nikolajevs/MISC/qb288-spool/README.md

# Печатная катушка для лифта лампы QB288

Катушка для троса на D-вал 6 мм мотор-редуктора **JGY-370, 12 В, 18 об/мин** (Aslong JGY-370B, например Evita.lt U-0096).
Рассчитана на лампу около 2 кг. Все размеры в миллиметрах.

## Файлы

| Файл | Что это |
|---|---|
| `spool_compact.stl` | **Основная версия.** Короткая, без ступицы, сидит на D-лыске и на клею. 15 г PETG. Не разбирается. |
| `spool_screw.stl` | Версия со ступицей, закладной гайкой M3 и стопорным винтом. Съёмная, но на 5 мм длиннее. 17 г PETG. |
| `d_fit_test.stl` | Пластинка с четырьмя D-отверстиями с разным зазором. Печатайте первой. |
| `spool.scad` | Параметрический исходник (OpenSCAD). Меняйте `flat_f`, `shaft_len`, `d_len`, `clear`, `core_d` и т.д. По умолчанию это compact, для screw задайте `hub_len = 4` и `flange_t = 3.5`. |

STL лежат в **печатной ориентации**: наружная щёчка на столе, D-отверстие или ступица смотрят вверх.

## 1. Сначала проверьте посадку

1. Измерьте штангенциркулем свой вал: диаметр, расстояние от лыски до противоположной стороны (по чертежам 5,4, допуск 5,3–5,5), длину вала от бобышки (чертёж Aslong 14 мм, даташит серии 16,5 мм, то есть 18,5 от корпуса, у продавцов 14–16) и длину лыски от конца вала (8–12).
2. Напечатайте `d_fit_test.stl`. Слева направо отверстия имеют зазор на сторону 0,05 / 0,10 / 0,15 / 0,20 мм по диаметру и на 0,05 мм больше по лыске (1–4 насечки на кромке).
3. Выберите отверстие, которое садится на вал от руки без люфта. Если это не 0,10 (по умолчанию), поменяйте `clear` в `spool.scad` и перегенерируйте STL.
4. Если лыска вала 5,45 мм и больше, поставьте измеренное значение в `flat_f`: при 5,5 зазор по лыске в модели всего около 0,05 мм.
5. Если лыска короче 8 мм, поправьте `d_len`: D-часть отверстия должна лежать только там, где у вала есть лыска.
6. **Зазор `gap` между торцом катушки и самой выступающей деталью на грани мотора.** Такая деталь это бобышка, поверхность L-кронштейна или головки винтов. Измерьте вылет вала `P` от этой детали и поставьте `gap` = `P` − 13,5 мм, но не меньше 0,5 мм. Тогда конец вала всегда оказывается на 13,5 мм от торца катушки и на 2 мм не доходит до дна, и те же STL подходят без перегенерации. Пример: по даташиту серии вал выступает на 18,5 мм от плоскости площадок, стальной L-кронштейн (3 мм) её поднимает на 3 мм, `P` = 15,5, `gap` = 2,0 мм. Если `P` < 14, `gap` получится меньше 0,5 мм: задайте в `spool.scad` `shaft_len` = `P` и `gap` = 0,5 и перегенерируйте катушку (D-часть сместится сама). Параметры `shaft_len` и `gap` в `spool.scad` меняйте только вместе. Как крепить сам мотор, см. лист 8 дизайна.

## 2. Печать

- Материал: **PETG** (PLA не брать: ползёт под нагрузкой при тепле палатки; нейлон тянет влагу).
- Слой 0,2 мм, сопло 0,4 мм, **5 периметров, заполнение 100%**.
- Ориентация как в STL. **Внутренняя щёчка Ø34 нависает над сердечником Ø26 на 4 мм**, это консоль, а не мост. Включите поддержки только от стола и только под этой щёчкой, зазор по Z 0,2 мм. Канавку поддержки не задевают. Если печатать без них, нижняя поверхность щёчки провиснет на десятые доли миллиметра и отпечатается неровной.
- Канавка винтовая, шаг 1,8 мм, полукруглый профиль радиусом 0,85 и глубиной 1,0 мм. Перемычки между витками очень узкие (около 0,1 мм), тоньше слоя, поэтому поверхность получится чешуйчатой. Трос лежит в круглом дне канавки, а не на перемычке, так что для работы это не страшно. Если боитесь, сначала распечатайте 15-мм кусок намотки.
- Версия `screw`: горизонтальное отверстие под винт и паз гайки печатаются мостом, это нормально. Гнездо Ø6,1 открыто на стол: после печати пройдите его свёрлом Ø6 (усадка и «слоновья нога» сужают устье).

## 3. Сборка

Общее:
1. Примерьте всухую: между торцом катушки и ближайшей деталью на грани мотора (бобышка, кронштейн, головки винтов) оставьте щуп толщиной `gap` (см. шаг 1.6). **Упора нет**: катушка не должна касаться этих деталей.

**Compact (клей, не разбирается):**
2. Зачистите вал и обезжирьте. Нанесите **эпоксидку или фиксатор для цилиндрических соединений** на дальнюю половину вала и на дно отверстия. У входа клея не оставляйте, чтобы он не выдавился в зазор 0,5 мм и не приклеил катушку к бобышке.
3. Наденьте катушку, держите щуп 0,5 мм до схватывания, до начала гелеобразования пару раз проверните катушку вручную.
4. Момент несут лыска и клей вместе: в compact основную долю берёт клеевой слой (расчётное касательное напряжение около 0,3–0,7 МПа при 0,25–0,5 Н·м). Разобрать можно только разрушив катушку.

**Screw (съёмная):**
2. Вставьте гайку M3 в паз со стороны торца ступицы (можно капля цианоакрилата).
3. Наденьте катушку, выставьте щуп 0,5 мм, затяните стопорный винт M3×6 (без головки) через отверстие в ступице: до касания и ещё на 1/8 оборота, не больше 0,1–0,15 Н·м. Винт стопорит от смещения вдоль вала, момент несёт лыска. На круглой части вала винт упирается в вал вровень со ступицей, это нормально. Длиннее M3×6 не брать: торчит.
4. Клея в этой версии нет, а лыска глубиной 0,6 мм в PETG работает на значительной доле запаса. Не доводите ход до упора и ограничьте его концевиками (см. лист 5 дизайна). При желании добавьте каплю фиксатора резьбы средней прочности на лыску.

## 4. Трос

- Плетёный трос **1,5 мм** (Dyneema или полиэстер). Стальной 7×19 при Ø25,5 по оси троса не подходит: D/d = 17, а рекомендуют 24–25, минимум 18. Для Dyneema достаточно D/d от 10.
- Конец троса продеть из канавки через отверстие Ø2,2 в наружной щёчке и завязать стопорный узел (двойная «восьмёрка») или обжать гильзой в выемке Ø6,0×1,6 на наружной стороне. Узел или гильза должны быть заметно крупнее отверстия. Dyneema скользкая: не полагайтесь на клей, он её не держит.
- Канавка начинается у отверстия для троса и идёт к редуктору. Кладите трос без нахлёста, натяжение умеренное.
- Направляющая проушина (куда трос выходит под катушкой) стоит напротив середины намотки (7,5 мм от щёчек) и **не ближе 150 мм** по вертикали: отклонение троса не больше ±2,9° от нормали к оси. Против одной щёчки угол вдвое больше.
- Ёмкость: 8,3 витка в канавке, на 500 мм хода нужно 6,2. Пригодно около 7,9 витка (трос радиусом 0,75 не ложится вплотную к щёчке), то есть при полностью размотанном тросе остаётся около 1,7 мёртвого витка. Этого достаточно, если узел крупнее отверстия: нагрузка на узел при трении троса о канавку 0,15–0,3 составит всего 20–4% нагрузки лампы. Нужен больший запас хода или 3 мёртвых витка: поставьте `wind_w` 17 мм и `pitch` 1,8 (или `pitch` 2,0 для более широких перемычек и `wind_w` 18).

## 5. Расчёт

| | Значение |
|---|---|
| Диаметр намотки по оси троса | 25,5 мм (D/d = 17) |
| Момент от лампы 2 кг | около 2,5 кг·см |
| Запас по номинальному моменту при статической нагрузке | ×1,9 при 4,8 кг·см (даташит серии: 12 В, 18 об/мин, 14 об/мин под нагрузкой, стоп 16 кг·см при 1 А), ×2,2 при 5,6 (Evita), ×3,5 при 9 (Oz / Aslong) |
| Скорость троса | около 19 мм/с при 14 об/мин под нагрузкой (500 мм за 27 с), около 24 мм/с при 18 об/мин без нагрузки |
| Масса катушки (PETG) | 15 г (compact), 17 г (screw) |

Запас считан по статической нагрузке. Рывки, трение в проушине и момент торможения в него не входят.

## 6. Нагрузка на вал мотора (важно)

Допустимая поперечная нагрузка на выходной вал JGY-370 в найденных мной листах данных не указана, а продавцы предупреждают не вешать груз на конец вала. Геометрия опоры вала в корпусе неизвестна, поэтому запас по этой нагрузке не гарантирован.

Лампа даёт около 20 Н. Плечо от корпуса (с учётом бобышки 2 мм и зазора 0,5 мм): compact 6–19 мм (рабочее 9–17), screw 11–24 мм (рабочее 14–22).

Что сделано и что делать:
- версия `compact` короче `screw` на 5 мм, плечо у неё меньше;
- трос должен идти строго перпендикулярно оси вала;
- в первые дни следите за люфтом вала и шумом;
- опорный подшипник на конце катушки здесь не предусмотрен намеренно: жёсткая опора делает вал статически неопределимым, и при несоосности даже 0,1 мм она может нагрузить вал силой в разы больше веса лампы. Если решите ставить, то только на плавающем или самоустанавливающемся кронштейне (в `spool.scad` есть параметр `stub_h` под гнездо штифта Ø6, но у версии screw нужно удлинить катушку).

## Что проверено, а что нет

- Размеры вала (Ø6, лыска 5,4): по заводскому чертежу Aslong, чертежу Handson и даташиту серии JGY-370 (github.com/microrobotics/JGY-370). Вылет вала в источниках расходится (14 мм от бобышки у Aslong, 18,5 мм от плоскости площадок в даташите серии), поэтому положение катушки подбирается через `gap`. Длина лыски у источников разная (8 или 12 мм), поэтому D-часть отверстия рассчитана на 8 мм от конца вала.
- Геометрия STL проверена программно независимыми проверками: отверстие не пересекается с валом при лыске 5,3 / 5,4 / 5,5, длине лыски 8 / 12 и длине вала 14 / 15; канавка непрерывна от отверстия для троса до внутренней щёчки; нулевых граней нет.
- `spool.scad` отрисован OpenSCAD 2021.01 и совпадает с STL по объёму с точностью около 0,2%. Рендер занимает около 3 минут: канавка тяжёлая.
- Печать на принтере, посадка на реальный вал, клей и сам лифт **не проверялись**. Для этого и нужна пробная пластинка.
