nikolajevs/MISC/qb288-spool/d_fit_test.stl

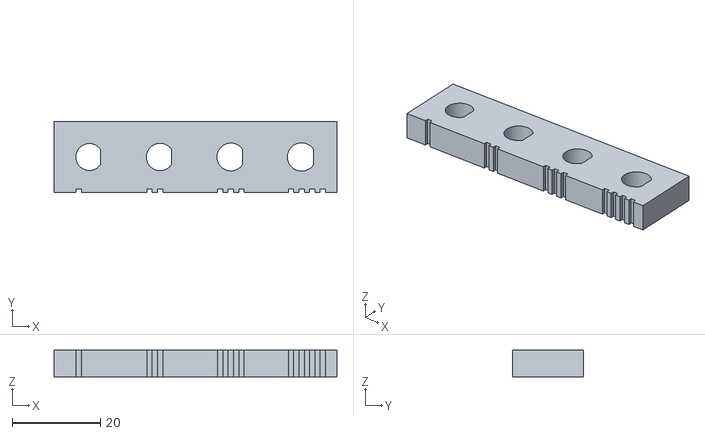
[picture p1: CAD file, 2026-10-13]
qb288-spool/d_fit_test.stl
64.0 x 16.0 x 6.00
