nikolajevs/MISC/qb288-spool/spool_compact.stl

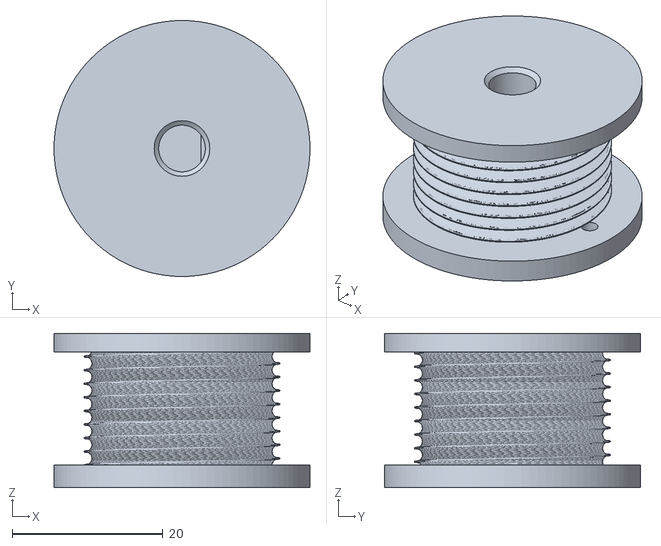
[picture p2: CAD file, 2026-10-13]
qb288-spool/spool_compact.stl
34.0 x 34.0 x 20.5
