nikolajevs/MISC/qb288-spool/spool_screw.stl

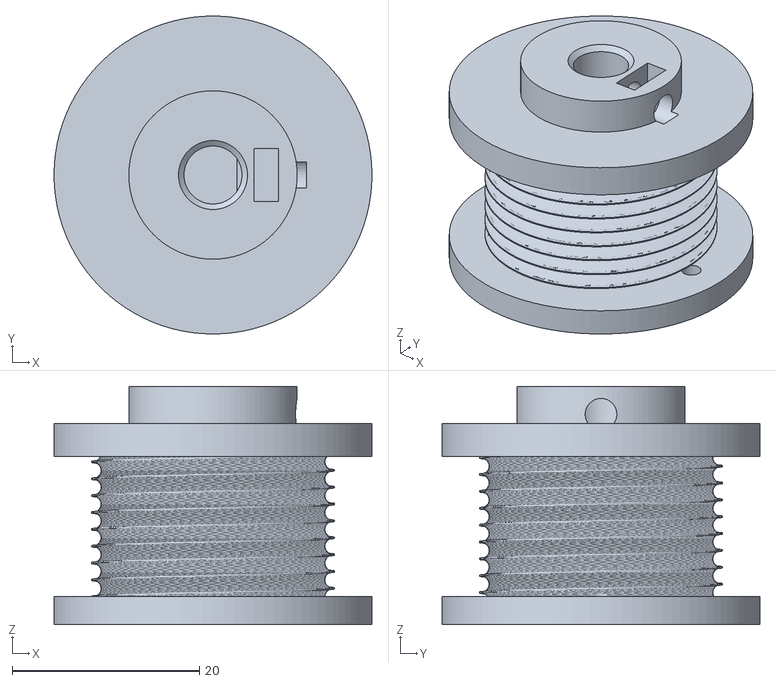
[picture p3: CAD file, 2026-10-13]
qb288-spool/spool_screw.stl
34.0 x 34.0 x 25.5
