nikolajevs/MISC/(commit log)

2026-10-13 Add printable rope spool for JGY-370 D-shaft (QB288 lamp lift)
    Parametric OpenSCAD source, two STL variants (compact glued, screw hub with M3 nut),
    a D-bore fit test plate and a README with print and assembly notes.
    Claude-Session: https://claude.ai/code/session_013PTuA6z8vdJMhaBhHjgDTH
    [d_fit_test.stl, spool.scad, spool_compact.stl, spool_screw.stl]
2026-10-13 Fix spool: shaft gap sign, flat clearance, smaller flange, clean mesh
    - tip of the shaft is at shaft_len - gap (was +gap), D section starts 1 mm earlier
    - extra 0.05 mm clearance on the flat (tolerance 5.3..5.5)
    - flange 38 -> 34 mm (4 mm overhang), supports advised under the inner flange
    - compact is now the default in spool.scad and spool_gen.py
    - drop zero-area triangles from the STL
    - README: assembly, supports, load on the motor shaft, honest wording
    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
    [d_fit_test.stl, spool.scad, spool_compact.stl, spool_screw.stl]
2026-10-13 Spool: datasheet data, gap rule, no stub hole in screw variant
    - add shaft length 16.5 (series datasheet) next to 14 (Aslong) and the rule gap = shaft_len - 13.5
    - torque margin against 4.8 kg.cm from the series datasheet
    - screw variant without the unused pin hole, README and SCAD header updated
    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
    [spool.scad, spool_screw.stl]
2026-10-13 README: gap rule for the L-bracket case
    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
